fan4tix/Eurorack-Scope/Hardware/1.0/Board2/BOM_Board2_Schematic2_2026-02-16.xlsx

Designator | Name | Footprint
C1,C2,C3,C7,C17,C19 | 10u | C0805,C1206
C4,C5,C6,C8,C12,C14,C18,C20,C21,C22 | 100n | C0603
H1,R11,R17,R19,SCREW1,SCREW2,SCREW3,SCREW4 | 36k | HDR-TH_8P-P2.54-V-M,R0603,Screw-Hole-M3
J1 | IN_A | EURORACK SHROUDED POWER 16 PIN
J2 | IN_B | EURORACK SHROUDED POWER 16 PIN
J3 | OUT_A | EURORACK SHROUDED POWER 16 PIN
J4 | OUT_B | EURORACK SHROUDED POWER 16 PIN
R4,R16 | 100k | R0603
R5 | 10K | R0603
R10,R18 | 200k | R0603
R12,R13,R14,R15,R23,R24,R25,R27,R30,R32,R35,R37,R40,R42,R45,R47,R50,R52,R55 | 10k | R0603
R26,R28,R31,R33,R36,R38,R41,R43,R46,R48,R51,R53 | 91k | R0603
R29,R34,R39,R44,R49,R54 | 60m | R1206
SJ1 | 3V3 | SJ_2S
SJ2 | 5V | SJ_2S
U3 | TL072CDT | SOIC-8_L5.0-W4.0-P1.27-LS6.0-BL
U4,U5,U9 | ADS1115IDGST | VSSOP-10_L3.0-W3.0-P0.50-LS4.9-BL
U6,U7,U8 | OPA2992IDR | SOIC-8_L4.9-W3.9-P1.27-LS6.0-BL
