fan4tix/Eurorack-Scope/Hardware/1.0/Board1/3D_PCB1_2026-02-16.step

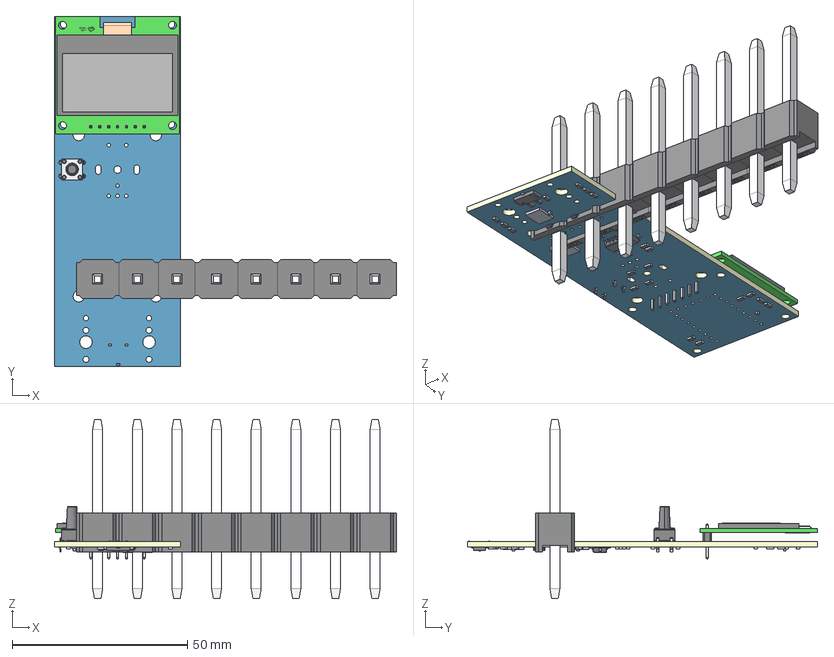
[picture p2: CAD file, 2026-03-11]
Hardware/1.0/Board1/3D_PCB1_2026-02-16.step
97.6 x 100.0 x 51.2 mm
Board~8jow
TopCopper~8jow
BottomCopper~8jow
TopFpcStiffener~8jow
BottomFpcStiffener~8jow
U5~SOIC-8_L5.0-W4.0-P1.27-LS6.0-BL~SOIC-8_ L5.0-W4.0-P1.27-LS6.0-BL~8jow x 2
HDR-TH_8P-P2.54-V-M~HDR-TH_8P-P2.54-V-M~8jow
SOD-323_L1.8-W1.3-LS2.5-RD~SOD-323_L1.8-W1.3-LS2.5-RD~8jow x 4
R0603~R0603~8jow x 30
C21~C0603~C0603_L1.6-W0.8-H0.8~8jow x 5
SOT-23-3_L2.9-W1.5-P2.0-LS2.5-BR~SOT-23-3_L2.9-W1.5-P2.0-LS2.5-BR~8jow
SOIC-14_L8.6-W3.8-P1.27-LS6.0-BL~SOIC-14_L8.6-W3.8-P1.27-LS6.0-BL~8jow
KEY-TH_4P-L6.0-W6.0-P3.90-LS6.5~KEY-TH_ 4P-L6.0-W6.0-H10.0-LS6.5-P3.9~8jow
LCD-TH_7P-P2.54_1.30OLED_7P~LCD-TH_7P-P2.54_1.30OLED_7P~8jow
