fan4tix/Eurorack-Scope/Hardware/1.0/Board2/3D_PCB2_2026-02-16.step

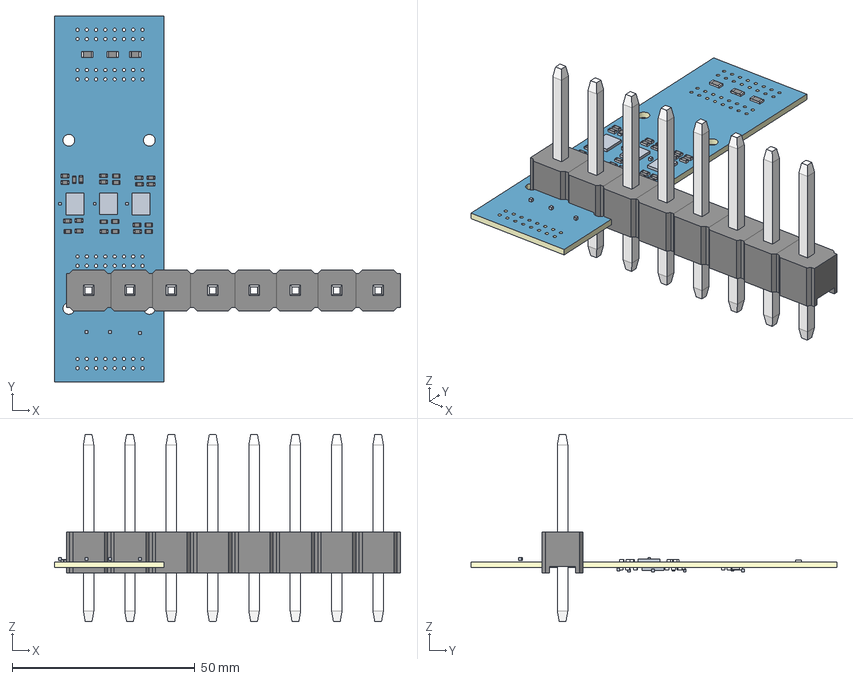
[picture p3: CAD file, 2026-03-11]
Hardware/1.0/Board2/3D_PCB2_2026-02-16.step
94.6 x 100.0 x 51.2 mm
Board~sPLe
TopCopper~sPLe
BottomCopper~sPLe
TopFpcStiffener~sPLe
BottomFpcStiffener~sPLe
C22~C0603~C0603_L1.6-W0.8-H0.8~sPLe x 10
SOIC-8_L5.0-W4.0-P1.27-LS6.0-BL~SOIC-8_L5.0-W4.0-P1.27-LS6.0-BL~sPLe
R1206~R1206_L3.2-W1.6-H0.6~sPLe x 6
R0603~R0603~sPLe x 39
HDR-TH_8P-P2.54-V-M~HDR-TH_8P-P2.54-V-M~sPLe
U8~SOIC-8_L4.9-W3.9-P1.27-LS6.0-BL~SOIC-8_ L4.9-W3.9-H1.7-LS6.0-P1.27~sPLe x 3
U9~VSSOP-10_L3.0-W3.0-P0.50-LS4.9-BL~VSSOP-10_ L3.0-W3.0-H1.1-LS4.9-P0.50~sPLe x 3
