fan4tix/Eurorack-Scope/Hardware/1.1/front-panel.stl

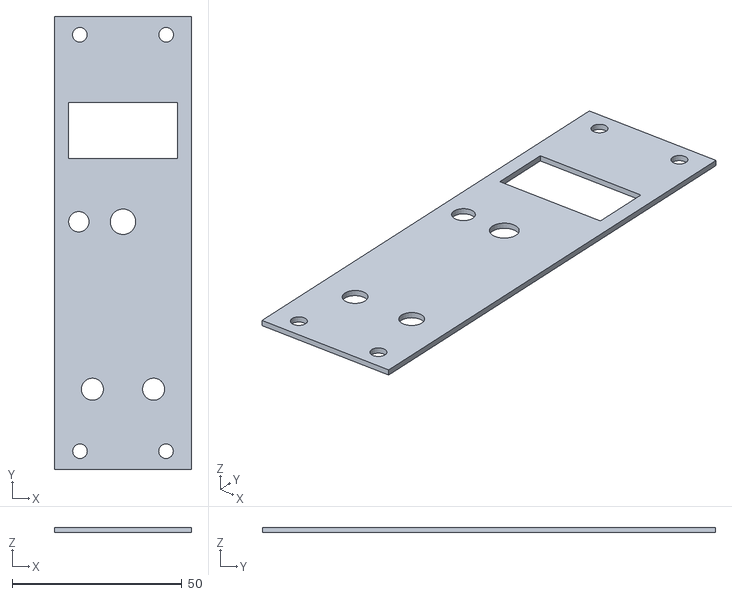
[picture p4: CAD file, 2026-10-14]
Hardware/1.1/front-panel.stl
40.3 x 133.3 x 1.50
