fan4tix/Eurorack-Scope/Hardware/1.1/PCB_PCB1_2026-10-14.pdf

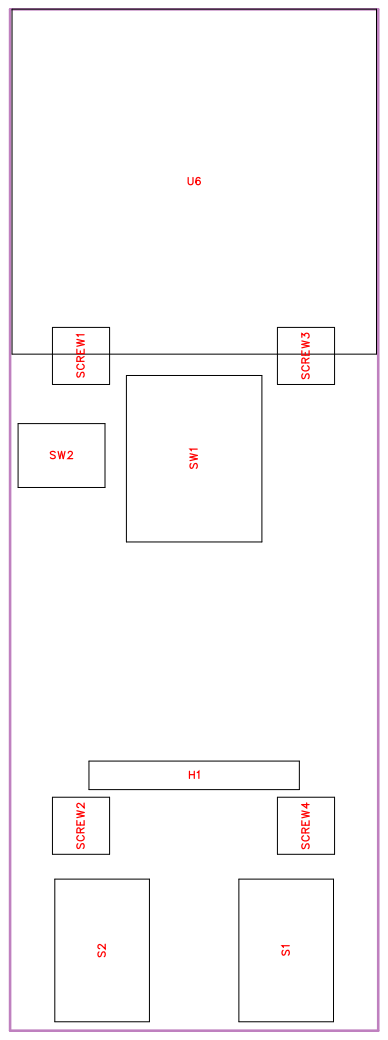
[picture p5: page 1]

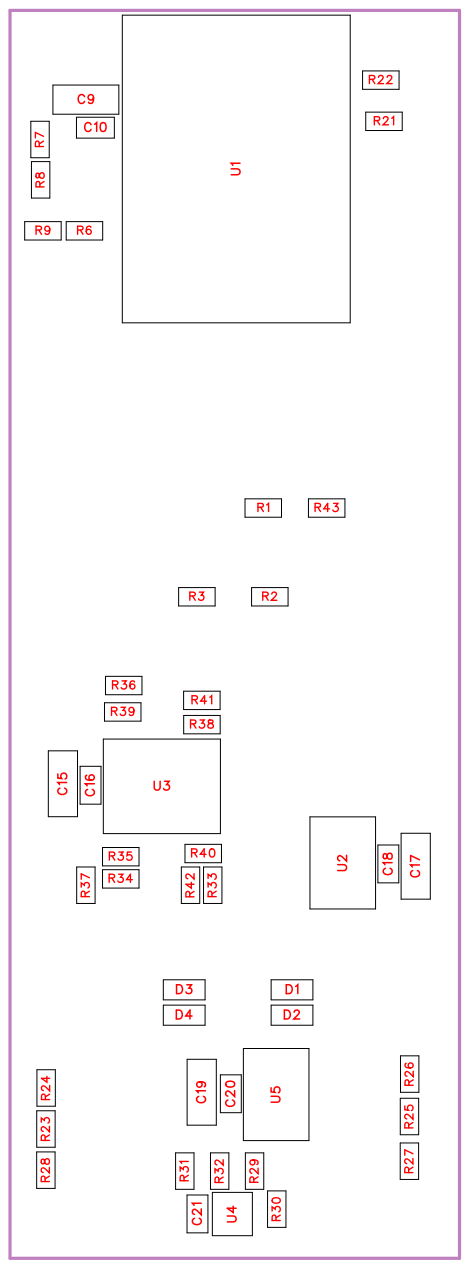
[picture p6: page 2]

Designator | Name | Footprint
C9,C15,C17,C19 | 10u | C1206
C10,C16,C18,C20,C21 | 100n | C0603
D1,D2,D3,D4 | 10V Zener | SOD-323_L1 .8-W1.3-LS2. 5-RD
H1,SCREW1,SCREW2,SC REW3,SCREW4,SW2 | | HDR-TH_8P-P2.54-V-M,K EY-TH_4P-L 6.0-W6.0-P3. 90-LS6.5,Scr ew-Hole-M3
R1,R2,R3,R9,R21,R22,R30, R43 | 10k | R0603
R6 | 36k | R0603
R7,R27,R28,R33,R34,R35, R36,R37,R38,R41,R42 | 100k | R0603
R8 | 200k | R0603
R23,R25 | 33k | R0603
R24,R26 | 6k2 | R0603
R29 | 2k7 | R0603
R31 | 1k8 | R0603
R32 | 100 | R0603
R39,R40 | 47k | R0603
S1 | CH2 | THONKICON N
S2 | CH1 | THONKICON N
SW1 | EC11K15244 02 | EC11-TH_E C11K152440 2
U1 | RP2040 Zero | RP2040-ZER O-TEMPORA RY
U2,U5 | TL072CDT | SOIC-8_L5.0 -W4.0-P1.27-LS6.0-BL
U3 | TL074ID | SOIC-14_L8. 6-W3.8-P1.2 7-LS6.0-BL
U4 | TL431 | SOT-23-3_L2 .9-W1.5-P2.0 -LS2.5-BR
U6 | 1.30OLED_7 P | LCD-TH_7P-P2.54_1.30O LED_7P

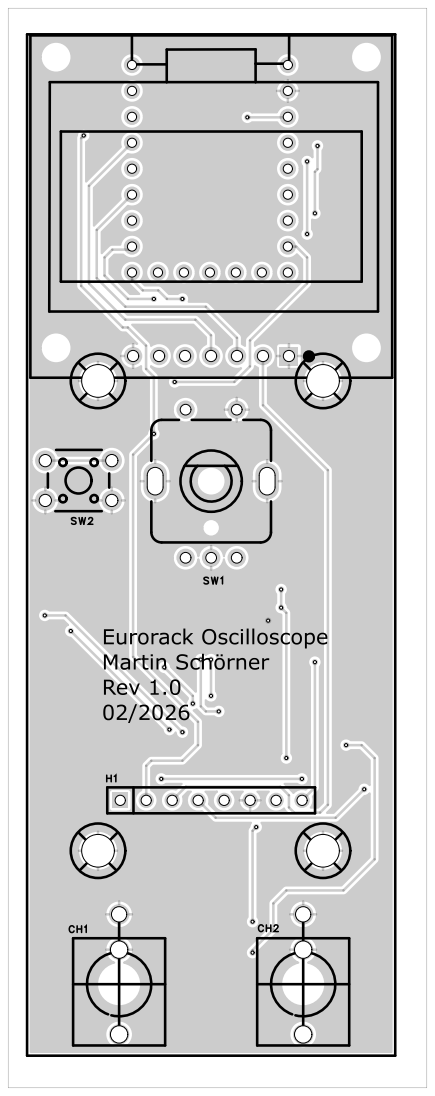
[picture p7: page 4]

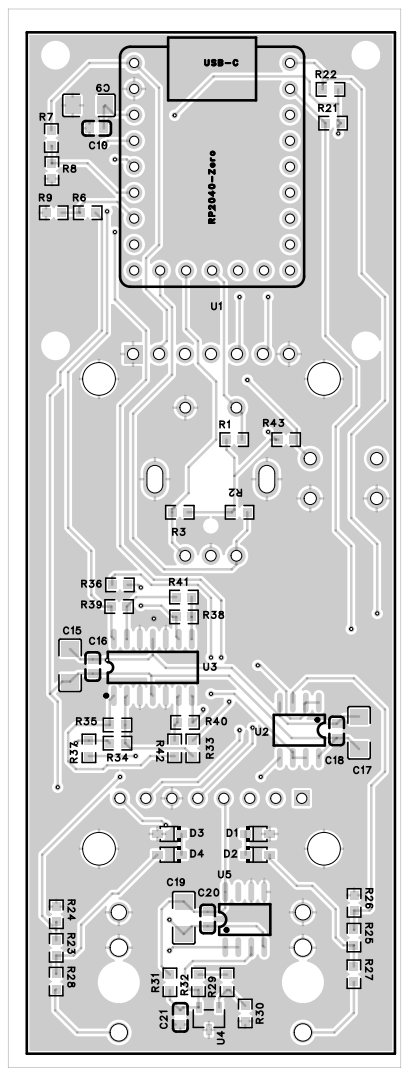
[picture p8: page 5]

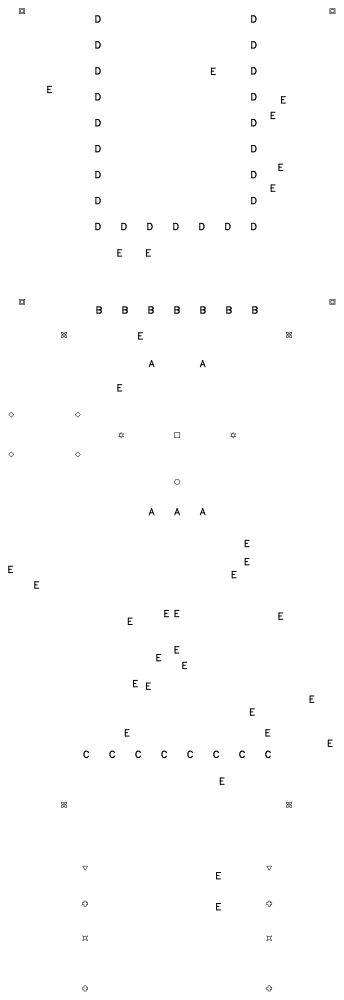
[picture p9: page 6]
