fan4tix/Eurorack-Scope/Hardware/1.1/PCB_PCB2_2026-10-14-1.pdf

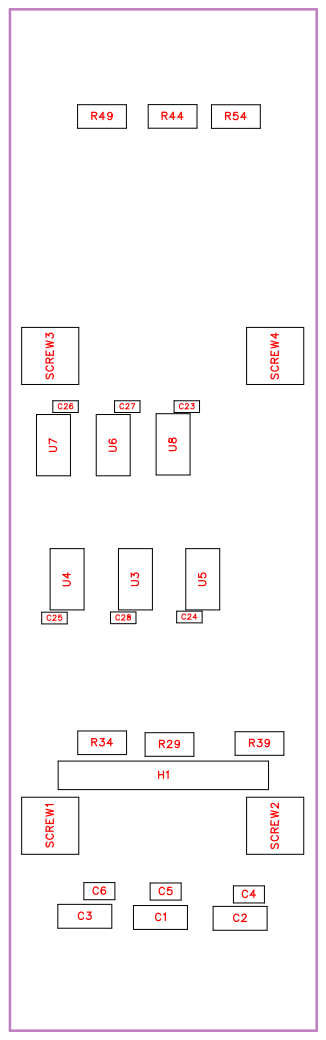
[picture p10: page 1]

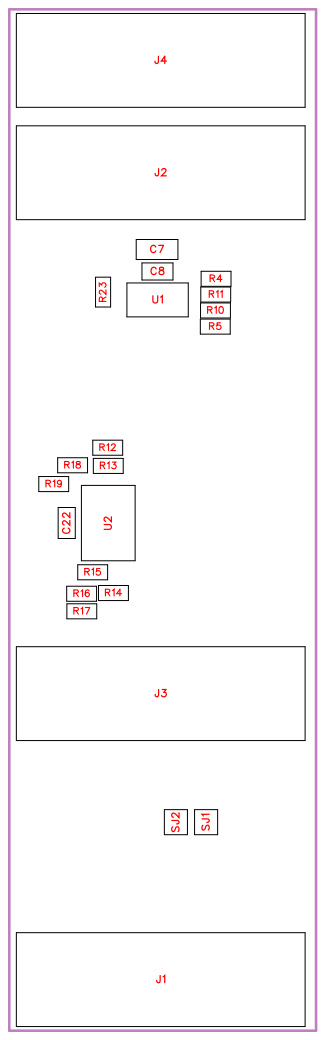
[picture p11: page 2]

Designator | Name | Footprint
C1,C2,C3,C7 | 10u | C0805,C120 6
C4,C5,C6,C8,C22 | 100n | C0603
C23,C24,C25,C26,C27,C28 | 100nF | C0402
H1,SCREW1,SCREW2,SC REW3,SCREW4 | | HDR-TH_8P-P2.54-V-M,S crew-Hole-M 3
J1 | IN_A | EURORACK SHROUDED POWER 16 PIN
J2 | IN_B | EURORACK SHROUDED POWER 16 PIN
J3 | OUT_A | EURORACK SHROUDED POWER 16 PIN
J4 | OUT_B | EURORACK SHROUDED POWER 16 PIN
R4,R16 | 100k | R0603
R5 | 10K | R0603
R10,R18 | 200k | R0603
R11,R17,R19 | 36k | R0603
R12,R13,R14,R15,R23 | 10k | R0603
R29,R34,R39,R44,R49,R54 | 60m | R1206
SJ1 | 3V3 | SJ_2S
SJ2 | 5V | SJ_2S
U1 | ADS1115IDG ST | VSSOP-10_L 3.0-W3.0-P0. 50-LS4.9-BL
U2 | TL072CDT | SOIC-8_L5.0 -W4.0-P1.27-LS6.0-BL
U3,U4,U5,U6,U7,U8 | INA226AQD GSRQ1 | VSSOP-10_L 3.0-W3.0-P0. 50-LS4.9-BL

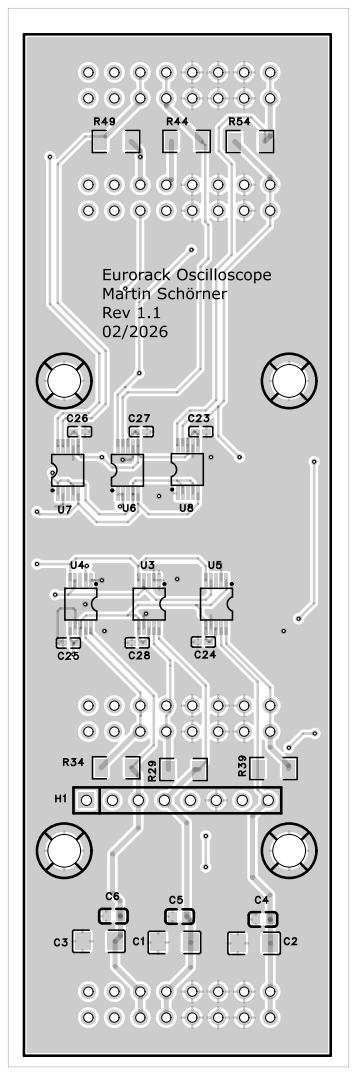
[picture p12: page 4]

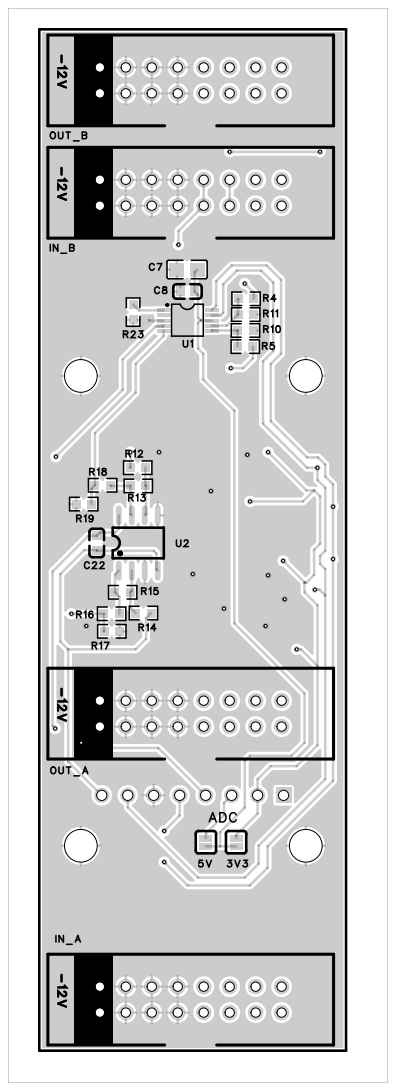
[picture p13: page 5]

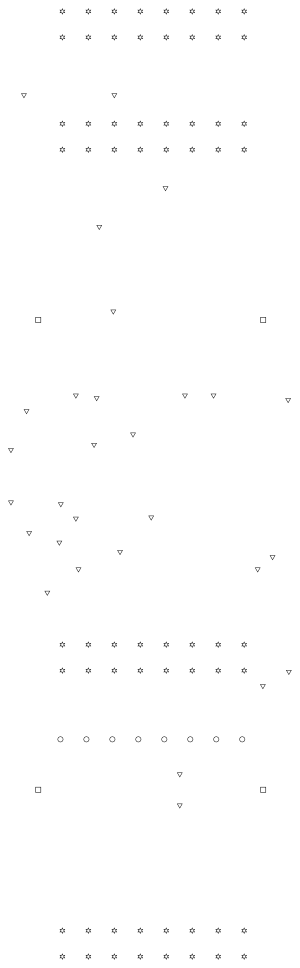
[picture p14: page 6]
