fan4tix/Eurorack-Scope/Hardware/1.1/SCH_Schematic1_2026-10-14.pdf

### GND GND

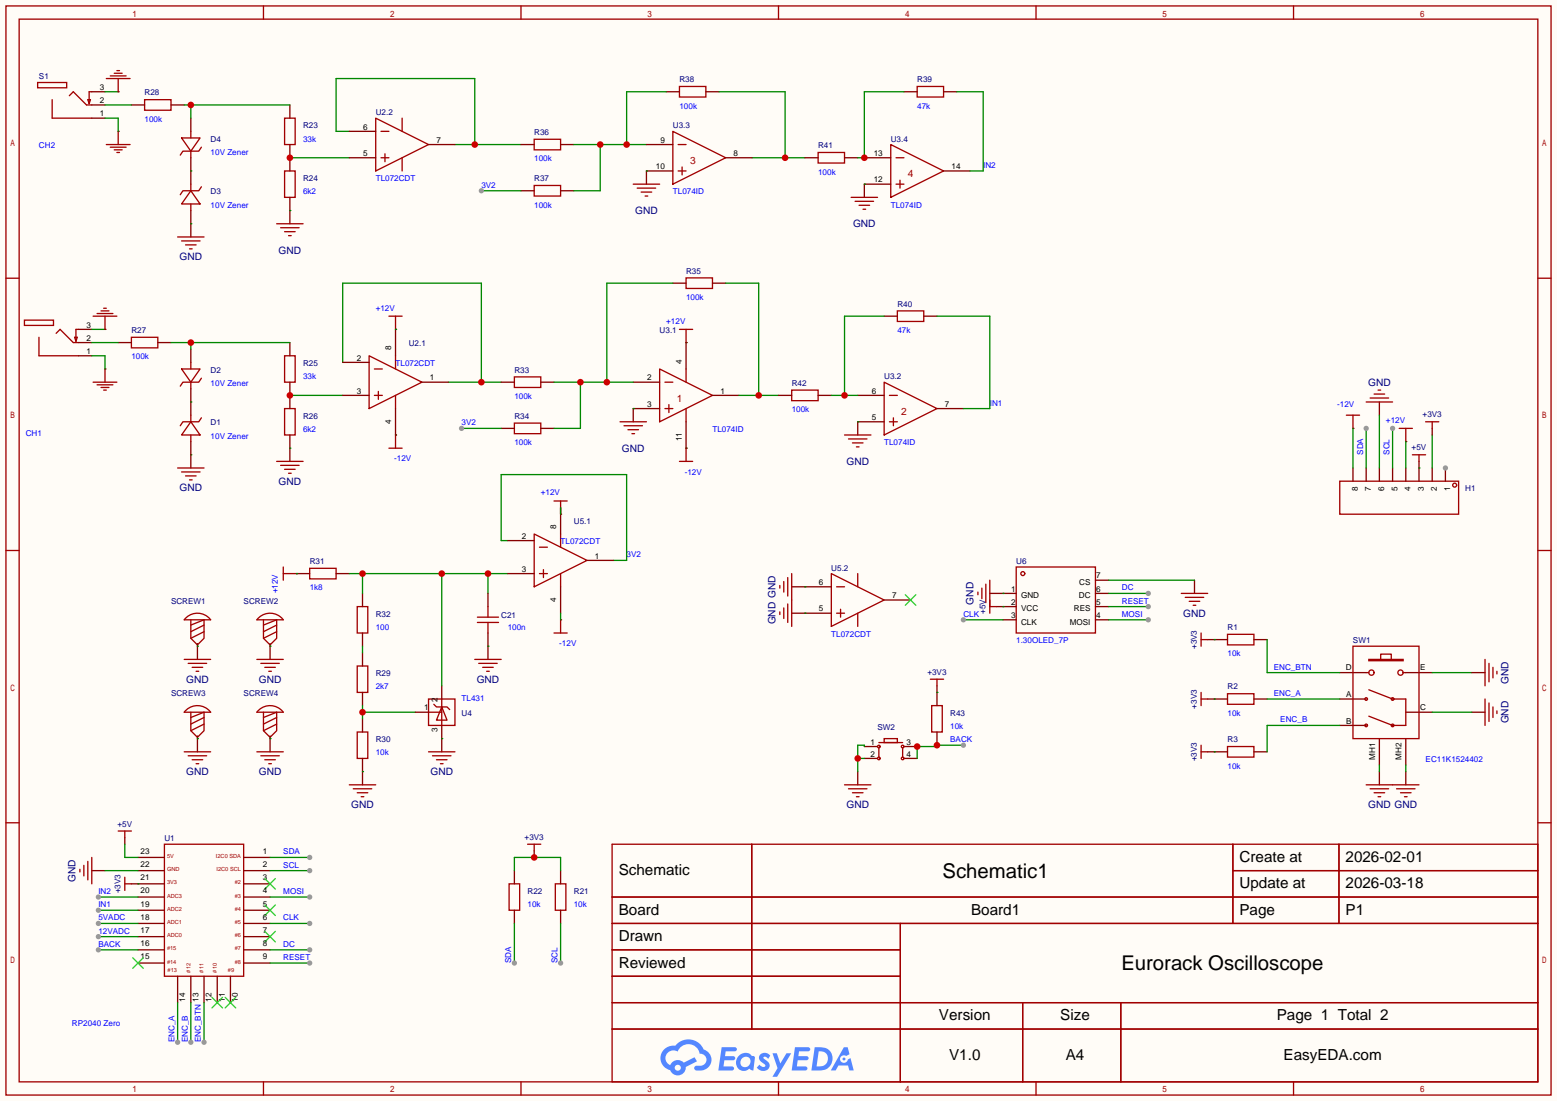
[picture p15: page 1]

Schematic | Schematic1 | Create at | 2026-02-01

Update at | 2026-03-18

Board | Board1 | Page | P1
Drawn | | Eurorack Oscilloscope
Reviewed

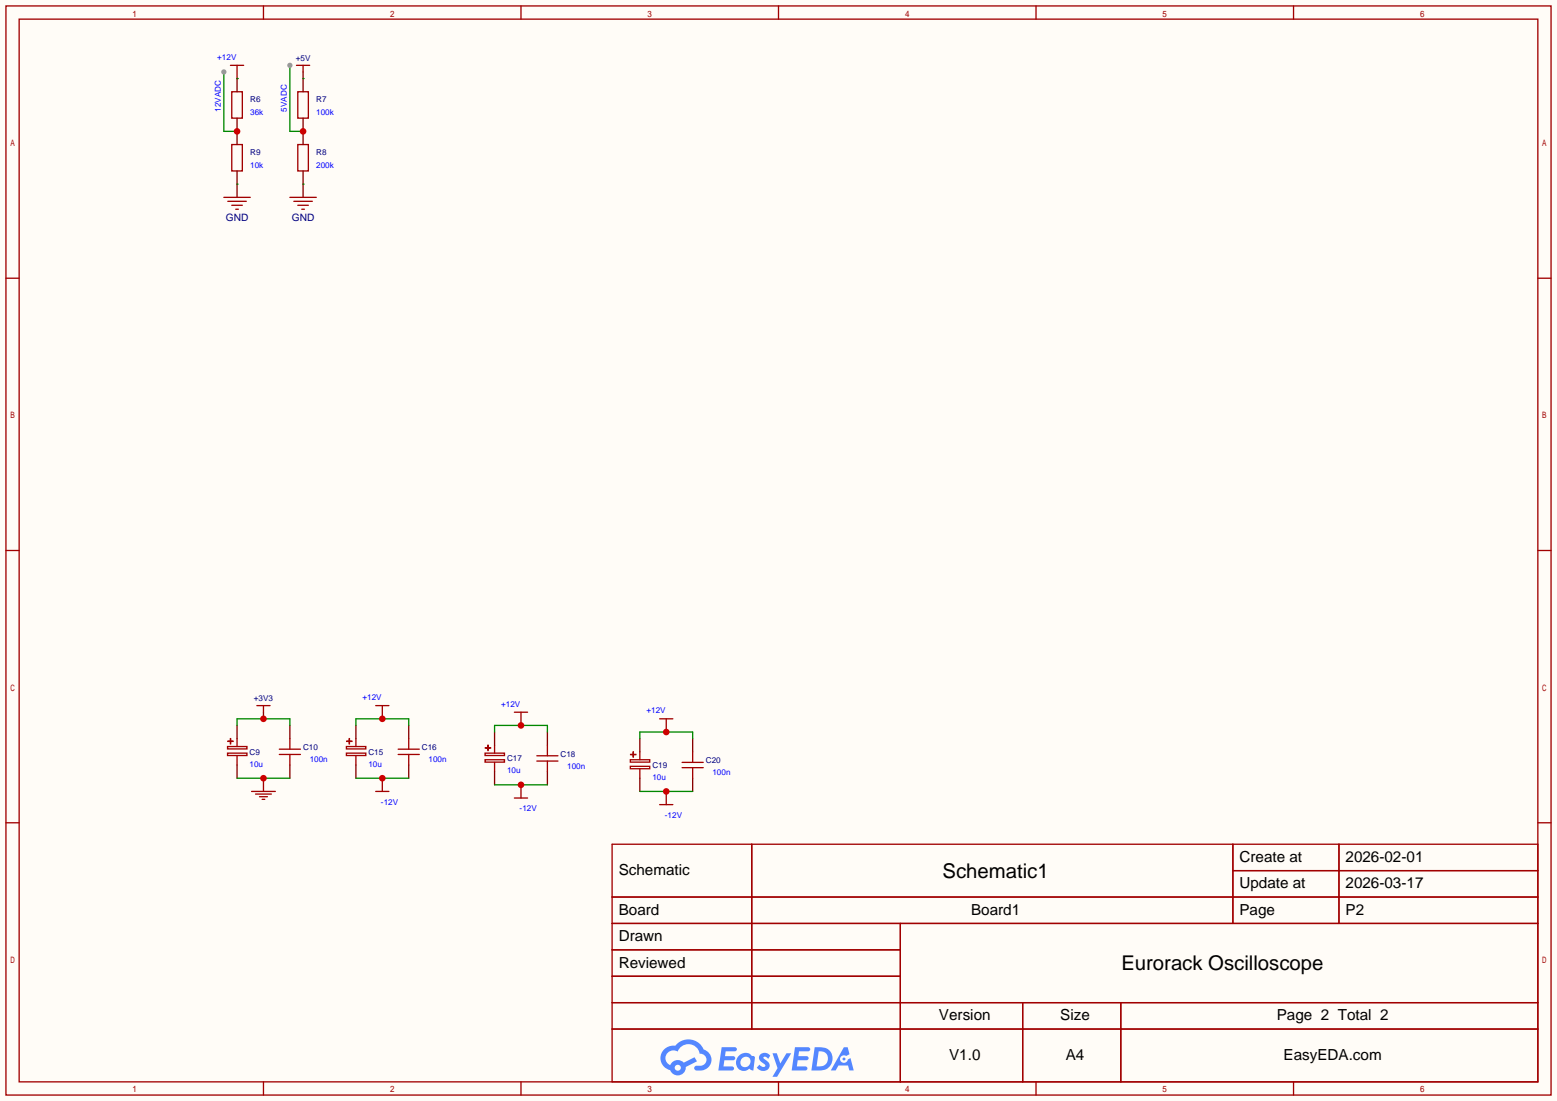
[picture p16: page 2]

Schematic | Schematic1 | Create at | 2026-02-01

Update at | 2026-03-17

Board | Board1 | Page | P2
Drawn | | Eurorack Oscilloscope
Reviewed

Version | Size | Page 2 Total 2

V1.0 | A4 | EasyEDA.com
