fan4tix/Eurorack-Scope/Hardware/1.1/SCH_Schematic2_2026-10-14-1.pdf

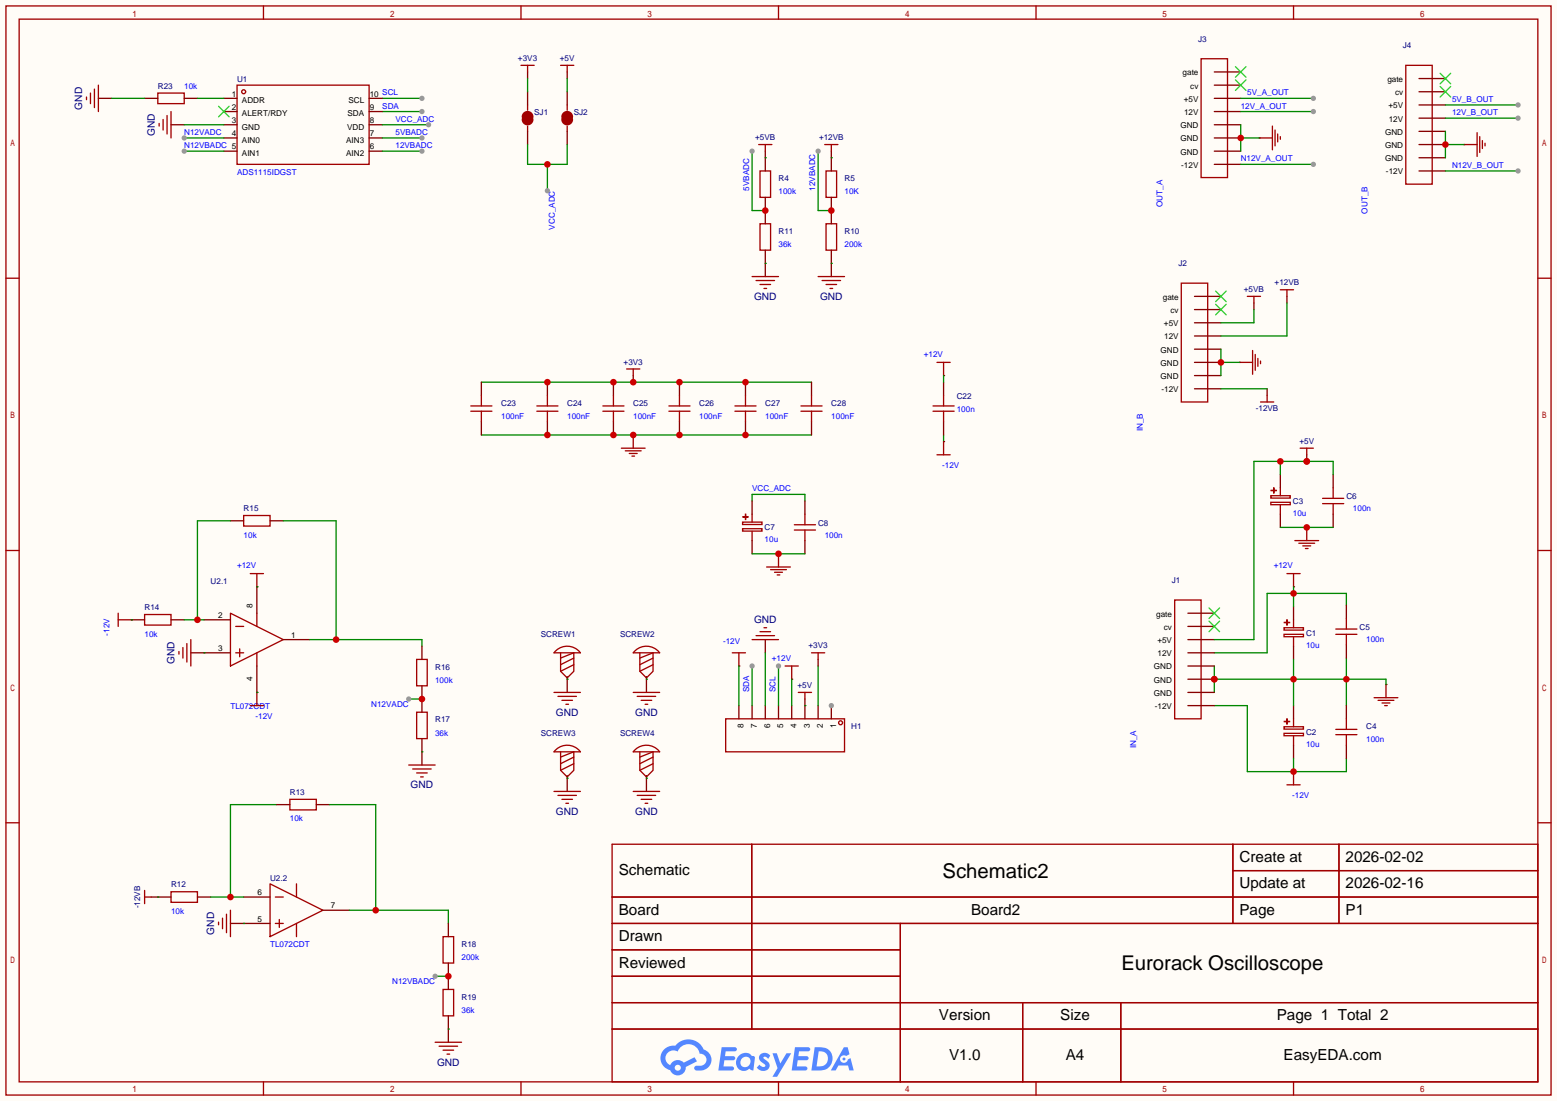
[picture p17: page 1]

Schematic | Schematic2 | Create at | 2026-02-02

Update at | 2026-02-16

Board | Board2 | Page | P1
Drawn | | Eurorack Oscilloscope
Reviewed

Version | Size | Page 1 Total 2

V1.0 | A4 | EasyEDA.com

# +3V3 GND

# +3V3GND

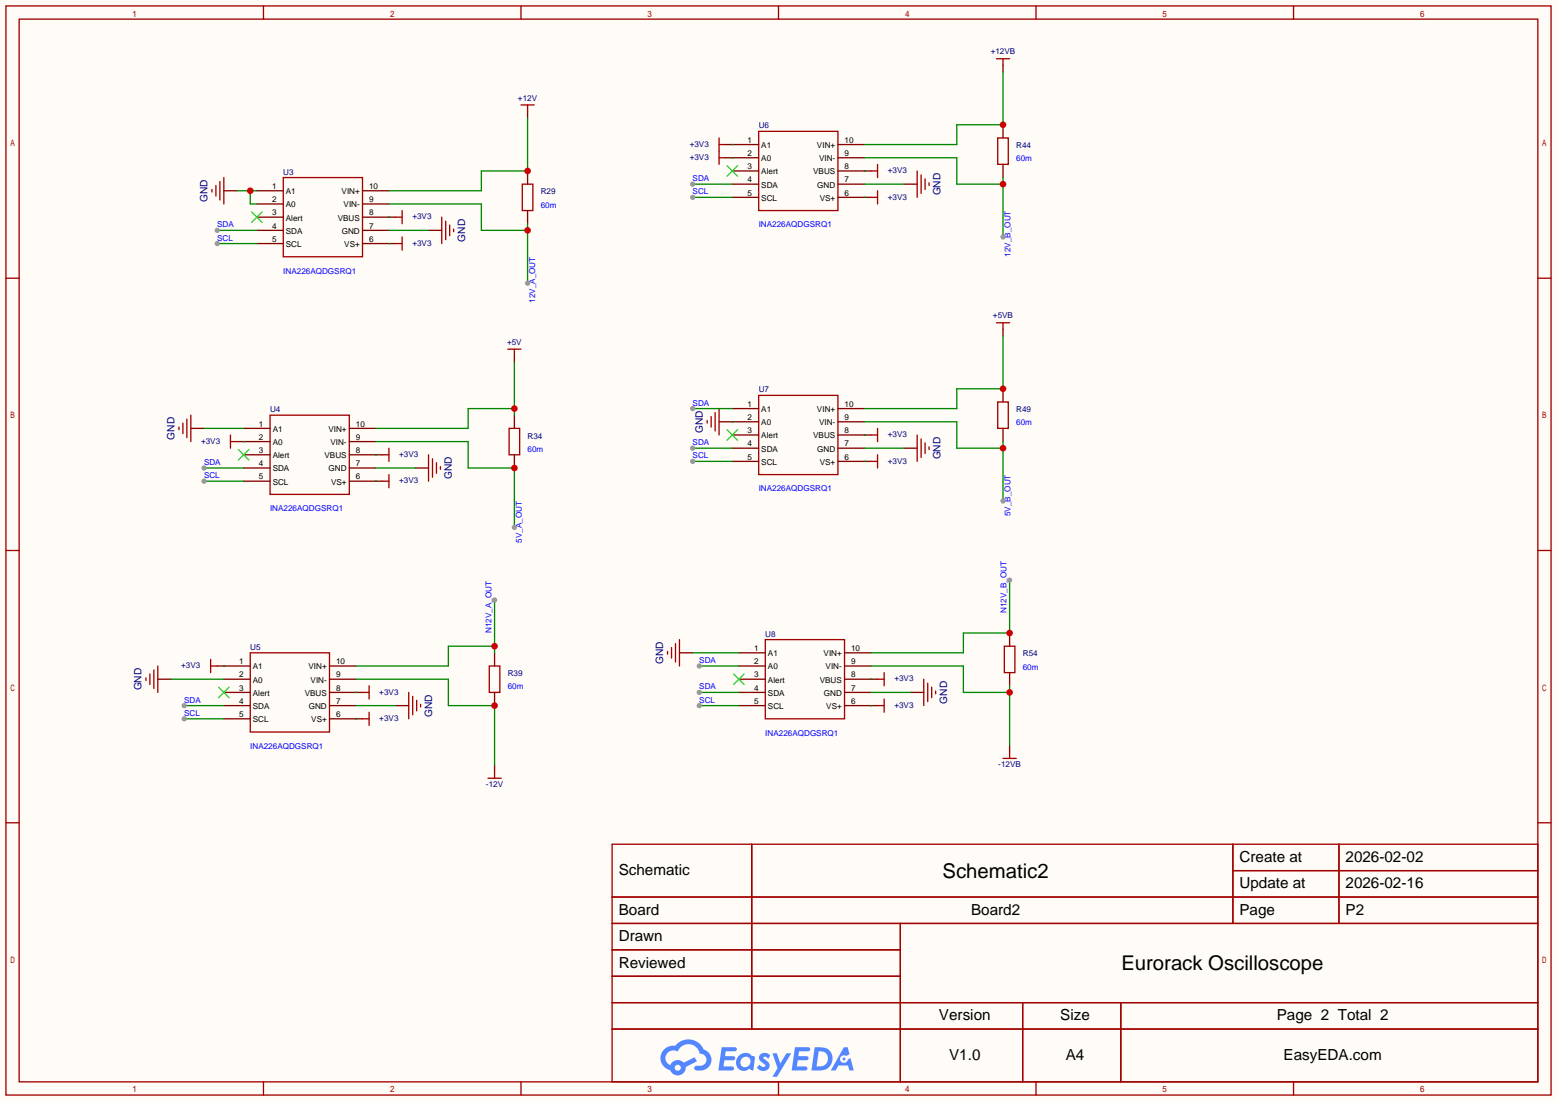
[picture p18: page 2]

Schematic | Schematic2 | Create at | 2026-02-02

Update at | 2026-02-16

Board | Board2 | Page | P2
Drawn | | Eurorack Oscilloscope
Reviewed

Version | Size | Page 2 Total 2

V1.0 | A4 | EasyEDA.com
