fan4tix/Eurorack-Scope/Hardware/1.0/Board1/SCH_Schematic1_2026-02-16.pdf

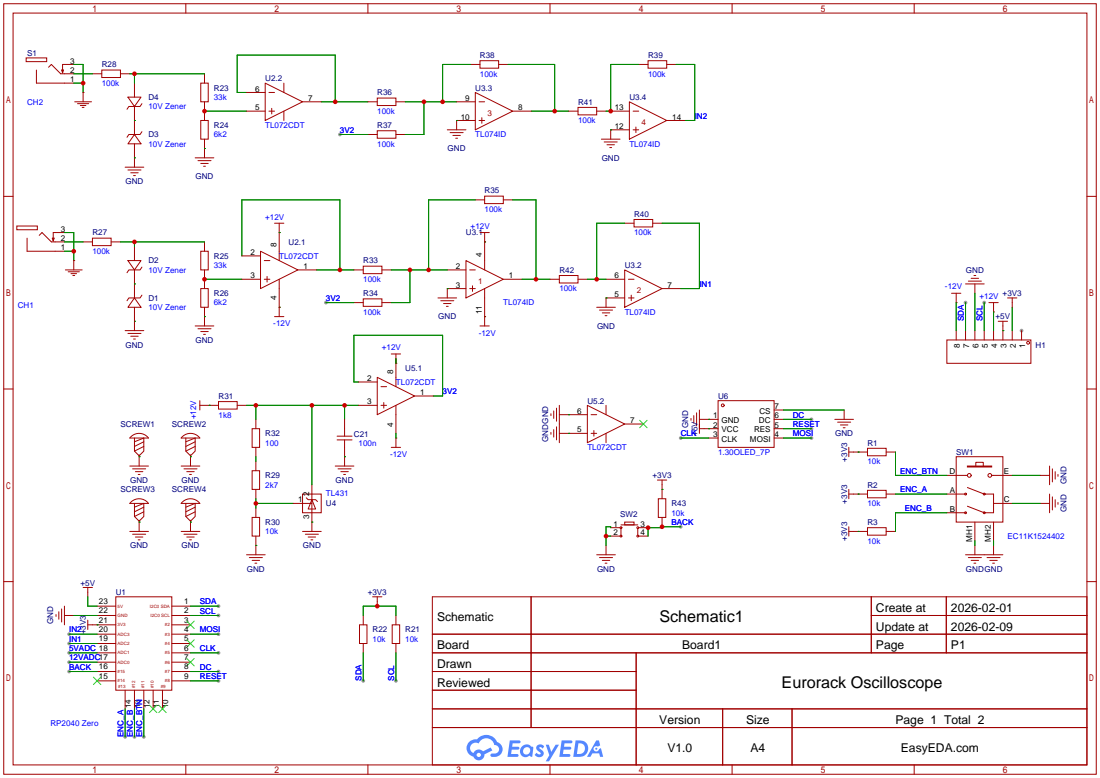
[picture p19: page 1]

Schematic | Schematic1 | Create at | 2026-02-01

Update at | 2026-02-09

Board | Board1 | Page | P1
Drawn | | Eurorack Oscilloscope
Reviewed

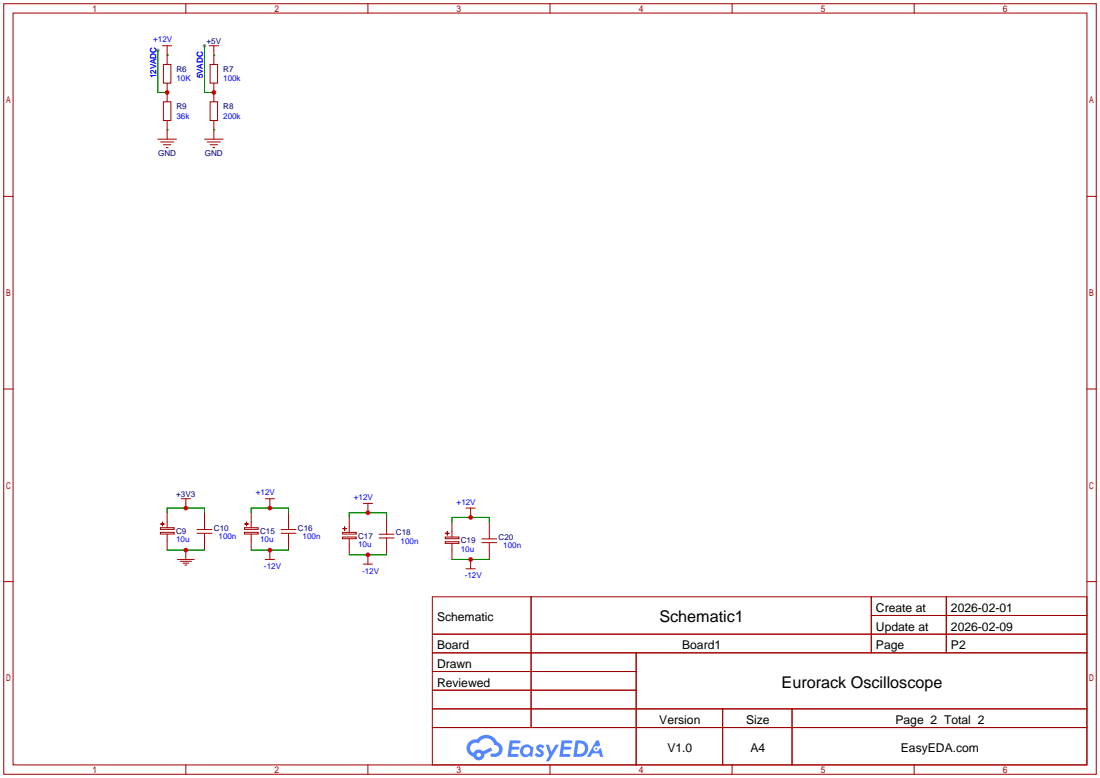
[picture p20: page 2]

Schematic | Schematic1 | Create at | 2026-02-01

Update at | 2026-02-09

Board | Board1 | Page | P2
Drawn | | Eurorack Oscilloscope
Reviewed

Version | Size | Page 2 Total 2
V1.0 | A4 | EasyEDA.com
