fan4tix/Eurorack-Scope/Hardware/1.0/Board2/SCH_Schematic2_2026-02-16.pdf

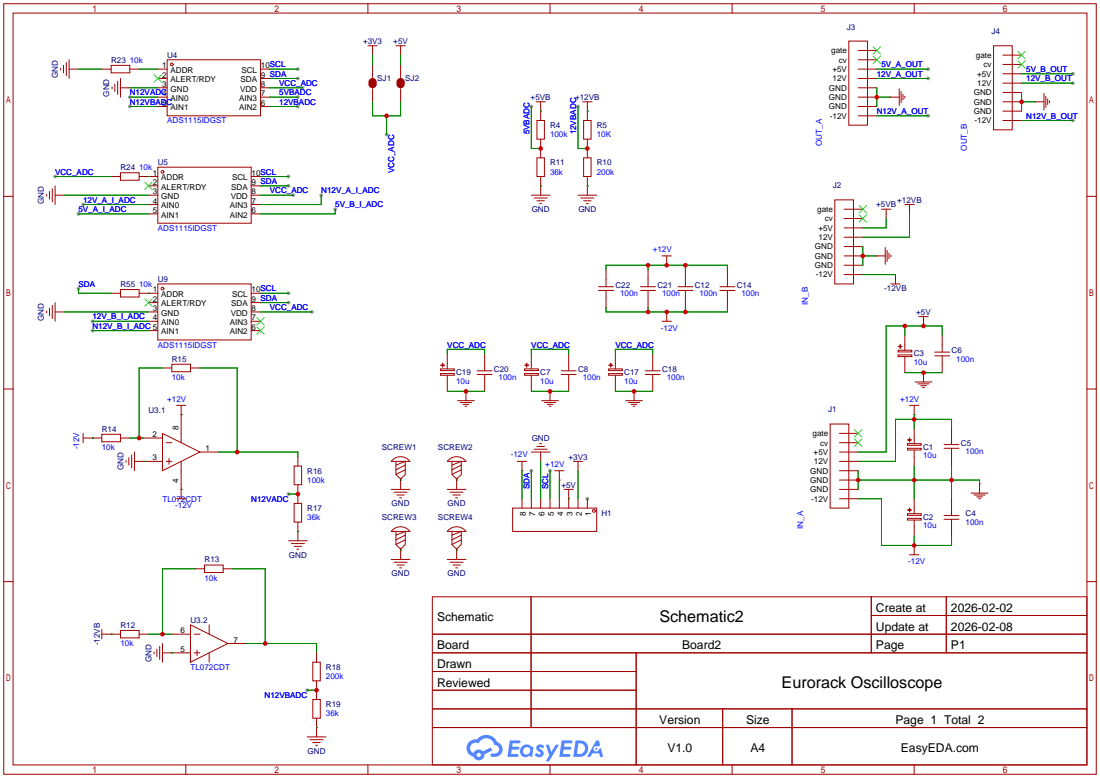
[picture p21: page 1]

Schematic | Schematic2 | Create at | 2026-02-02

Update at | 2026-02-08

Board | Board2 | Page | P1
Drawn | | Eurorack Oscilloscope
Reviewed

Version | Size | Page 1 Total 2
V1.0 | A4 | EasyEDA.com

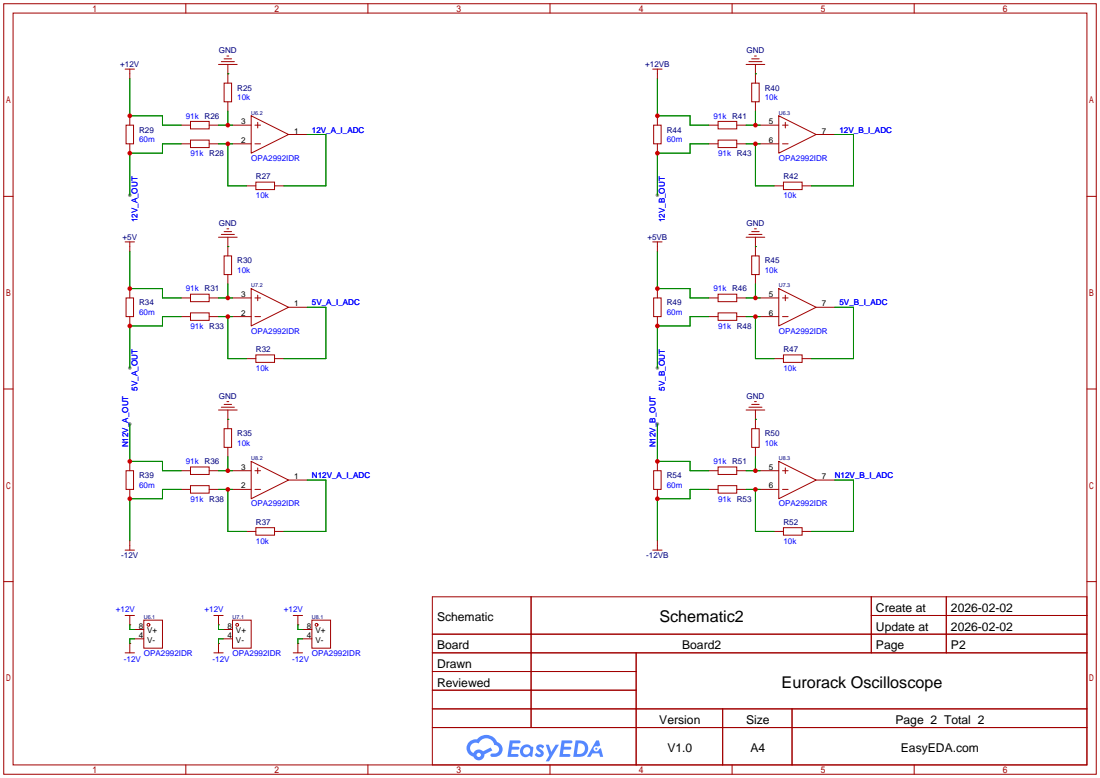
[picture p22: page 2]

Schematic | Schematic2 | Create at | 2026-02-02

Update at | 2026-02-02

Board | Board2 | Page | P2
Drawn | | Eurorack Oscilloscope
Reviewed

Version | Size | Page 2 Total 2
V1.0 | A4 | EasyEDA.com
