fan4tix/Eurorack-Scope/Hardware/1.0/Board1/PCB_PCB1_2026-02-16.pdf

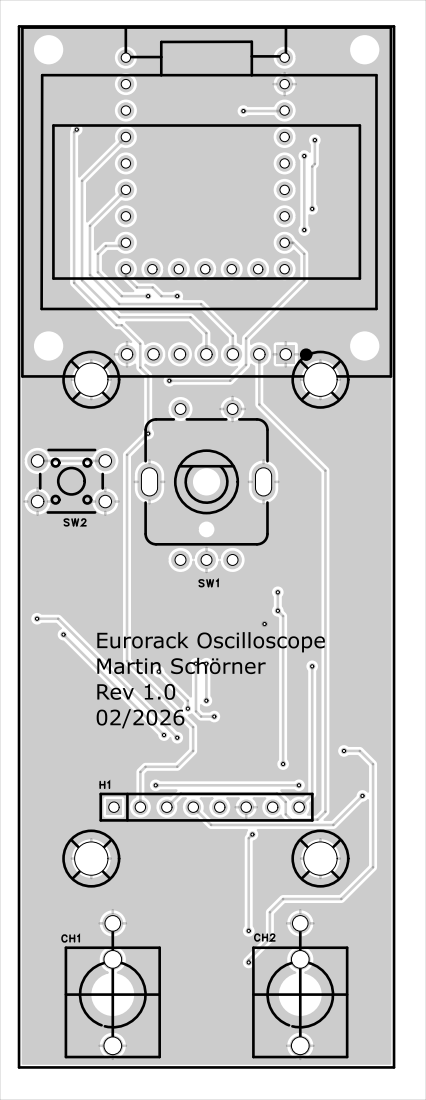
[picture p23: page 1]

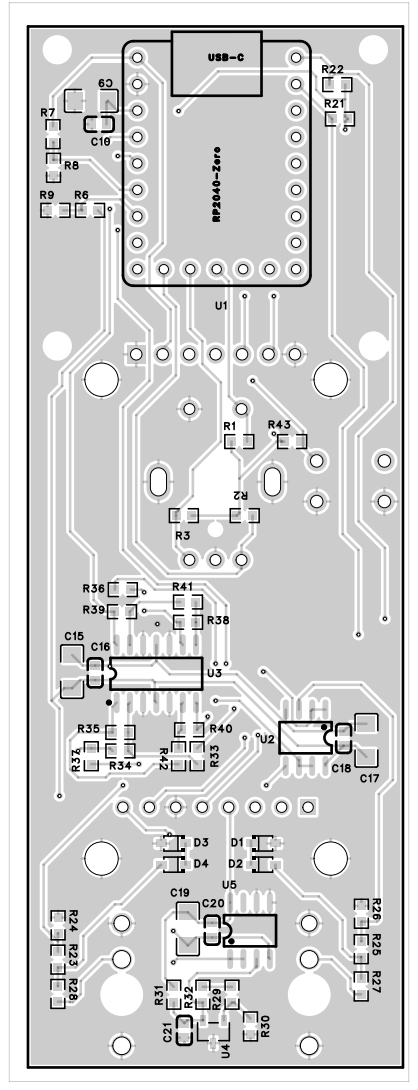
[picture p24: page 2]

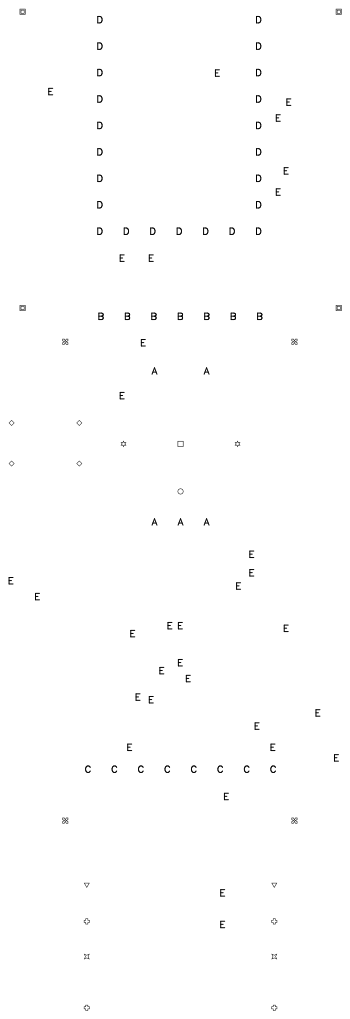
[picture p25: page 3]
