fan4tix/Eurorack-Scope/Hardware/1.0/Board2/PCB_PCB2_2026-02-16.pdf

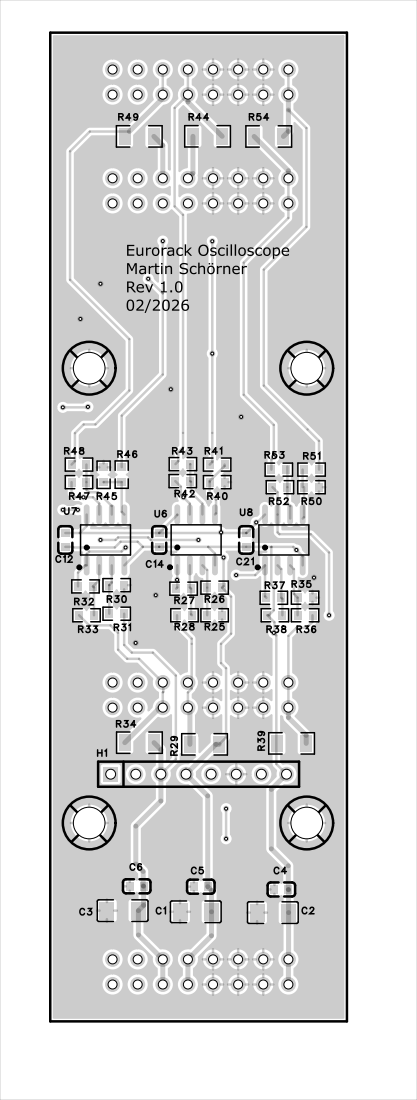
[picture p26: page 1]

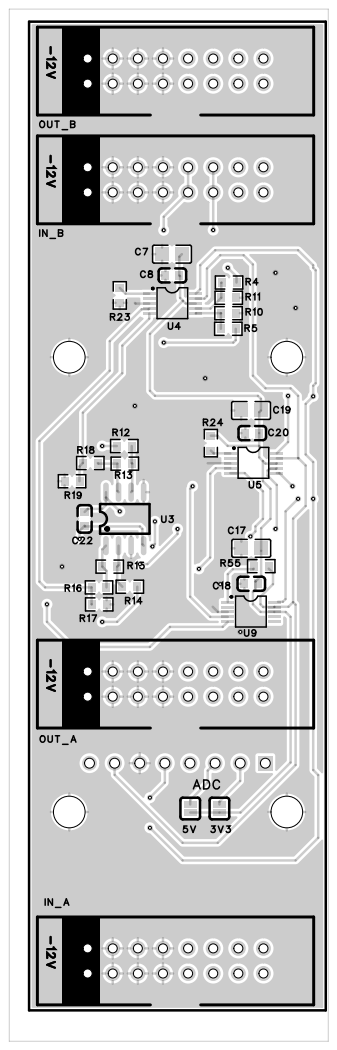
[picture p27: page 2]

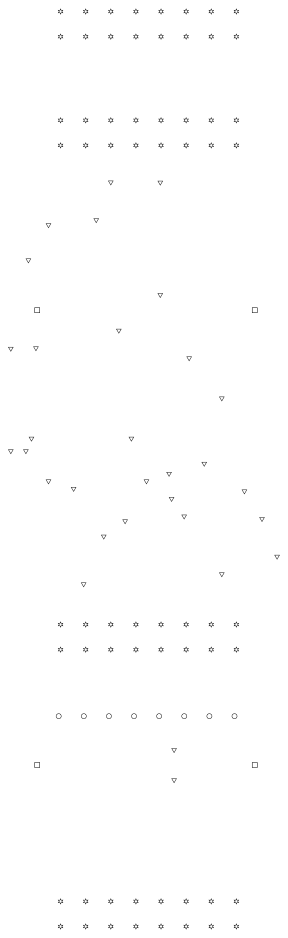
[picture p28: page 3]
