fan4tix/Eurorack-Scope/EurorackScope/pinout.h

#pragma once


#define P_ENC_A 12
#define P_ENC_B 13

#define P_ENC_BTN 11

#define P_BACK_BTN 15

#define P_OLED_MOSI 3
#define P_OLED_CLK 5
#define P_OLED_DC 7
#define P_OLED_CS 14
#define P_OLED_RESET 8
#define P_OLED_MISO 4


#define P_SDA 0
#define P_SCL 1
