fan4tix/Eurorack-Scope/EurorackScope/PSUApp.h

#pragma once
#include "App.h"

class PSUApp : public App {
public:
  PSUApp(const Menu* menu);

  void draw(UIContext& ctx, bool fullRedraw) override;

private:
  bool _gridDrawn = false;
  int8_t _screen = 0;  // 0 = voltage, 1 = current
};
