fan4tix/Eurorack-Scope/(commit log)

2026-03-17 calibrated psu adc
2026-03-17 ch 1+2 modification in several apps + more psu voltage scaling
2026-03-18 + current sensing in psu tab
2026-03-25 major bugfixes in scope, fft, tuner
    [DSP.cpp, DSP.h, DSPChannel.cpp, DSPChannel.h, EurorackScope.ino, FFTApp.cpp, FFTApp.h, Menu.h]
2026-03-25 + lissajous, +ch2 bugfix in scope
    [DSPChannel.h, LissajousApp.cpp, LissajousApp.h, ScopeApp.cpp]
2026-03-25 fixed psu voltages
2026-03-25 Voltmeter adc setup
2026-03-25 calibrate function
2026-10-14 + v1.1 HW
    [front-panel.stl]
